RocketVII/Atomian-tensile-strength-tester/README.md

# Atomian-tensile strength tester 
 A project that aimed to recreate a tensile strength tester

Video links:
https://youtu.be/b_F_LkmHzbg
 
https://youtube.com/shorts/Y3lAOohDtaM
 
https://youtube.com/shorts/8C9w-N7GyHU

## Repository Contents:
The Repository contains a the needed documents to recreate the project.
The project focused on achieve great ease of use functionality by creating a User friendly interface and removing the dependency on the laptop
By using a TFT Screen to display the interface in addition to a live plot the project
in addition to an SD card to export the needed data in combination to RTC module recreate some of the Commercial systems functionality
This created the framework for future Tensile Strength testers that utilize the Arduino without the need for the Arduino IDE after the set up

## System Parts:
* [Fishing Reel](https://www.amazon.com/dp/B07HRM2SMN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)
* [20 kg Load cell ](https://www.amazon.com/Bolsen-Tech-Portable-Electronic-Weighing/dp/B07N5KTQ2L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)
* [USB MicroSD Card Reader/Writer](https://www.adafruit.com/product/939)
* [SD module](https://www.amazon.com/dp/B07BJ2P6X6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)
* [TFT LCD display](https://www.adafruit.com/product/1480)
* [Distance Sensor](https://www.adafruit.com/product/3967)
* [C clamps](https://www.amazon.com/dp/B0991XPLGM?ref=ppx_yo2ov_dt_b_product_details&th=1)
* [DS3231 AT24C32 IIC RTC Module Clock](https://www.amazon.com/AT24C32-Replace-Arduino-Batteries-Included/dp/B07Q7NZTQS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)
* [Arduino Mega](https://www.amazon.com/dp/B01H4ZLZLQ?psc=1&ref=ppx_yo2ov_dt_b_product_details)
* [16 Keys Matrix Keypad](https://www.amazon.com/dp/B07B4DR5SH?psc=1&ref=ppx_yo2ov_dt_b_product_details)

## Software Dependencies:
* [Adafruit GFX Library](https://github.com/adafruit/Adafruit-GFX-Library)
* [HX711](https://github.com/bogde/HX711)
* [Adafruit VL53L1X Library](https://github.com/adafruit/Adafruit_VL53L1X)
* [RTClib](https://github.com/adafruit/RTClib)
* [Keypad library for Arduino](https://github.com/Chris--A/Keypad)
* [Adafruit ILI9341 Arduino Library](https://github.com/adafruit/Adafruit_ILI9341)
