RocketVII/Atomian-tensile-strength-tester/Presentation/Team3_Final_presentation.pdf

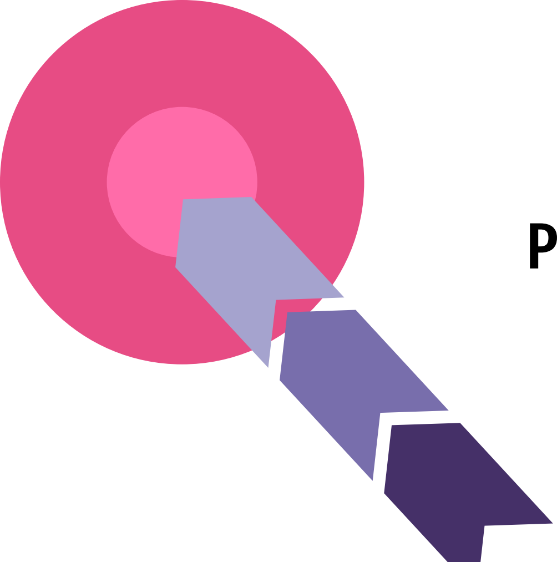
[picture p11: figure]

# Project Goals

### Team 3

# Project Goals

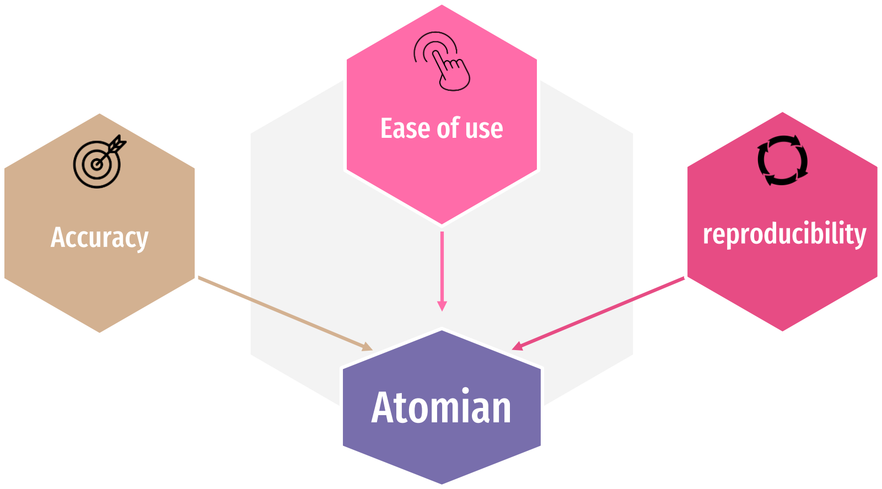
[picture p12: figure]
Atomian; reproducibility; Ease of use; Accuracy

# Identifying The Old System Issues

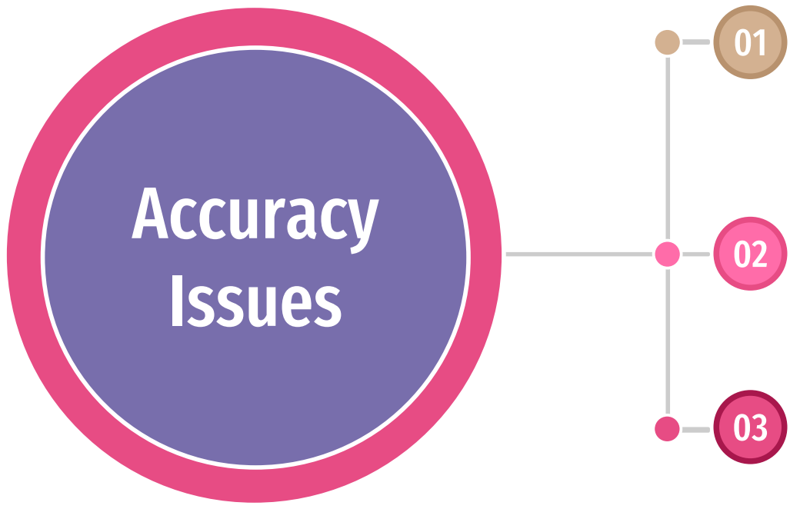
[picture p13: figure]
Accuracy Issues

# Load cell

# Distance Sensor

# Applying force

# Old system Data collection proccess

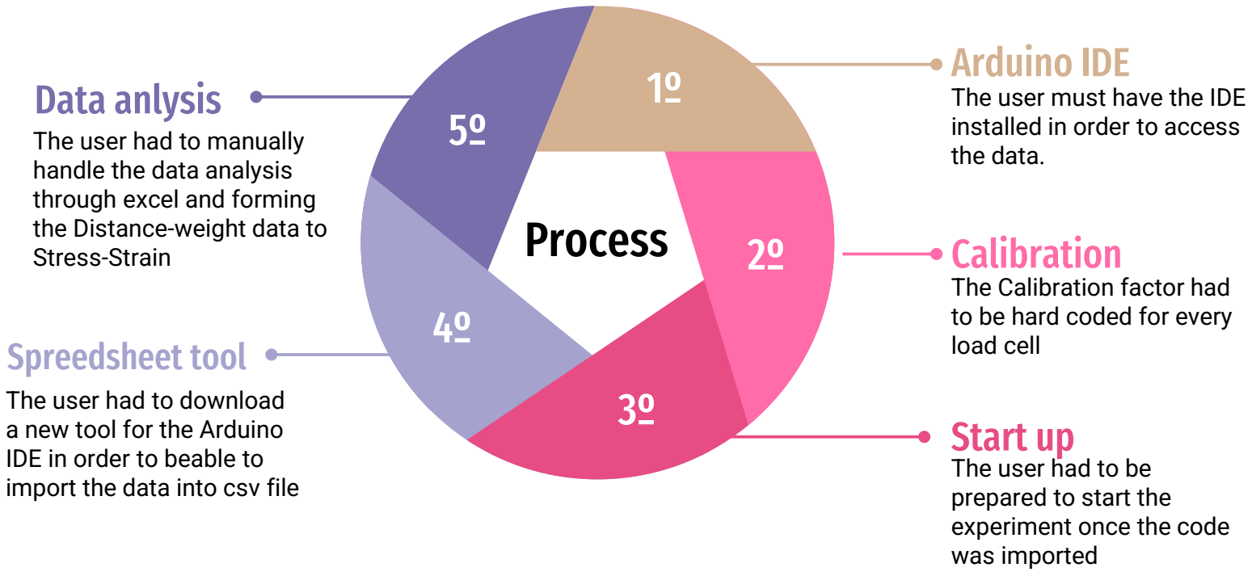
[picture p14: figure]
Data anlysis; The user had to manually handle the data analysis through excel and forming the Distance-weight data to Stress-Strain; Spreedsheet tool; The user had to download a new tool for the Arduino IDE in order to beable to import the data into csv file; Start up; The user had to be prepared to start the experiment once the code was imported; Calibration; The Calibration factor had to be hard coded for every load cell; The user must have the IDE installed in order to access the data.; Arduino IDE 1º; Process

# Proposed Solution

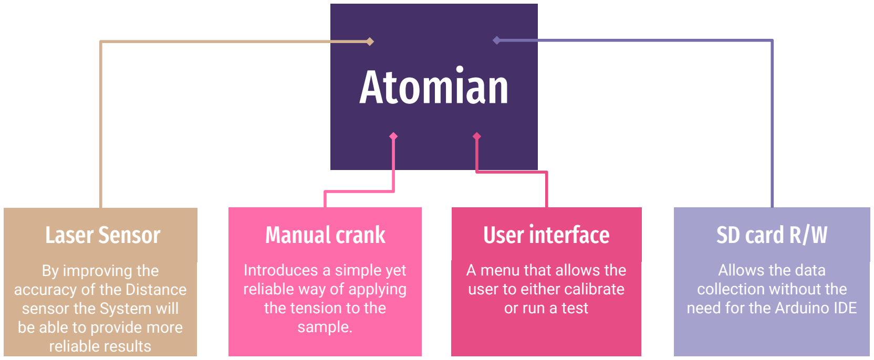
[picture p15: figure]
Atomian; By improving the accuracy of the Distance sensor the System will be able to provide more reliable results; Laser Sensor; Allows the data collection without the need for the Arduino IDE; SD card R/W; A menu that allows the user to either calibrate or run a test; User interface; Introduces a simple yet reliable way of applying the tension to the sample.; Manual crank

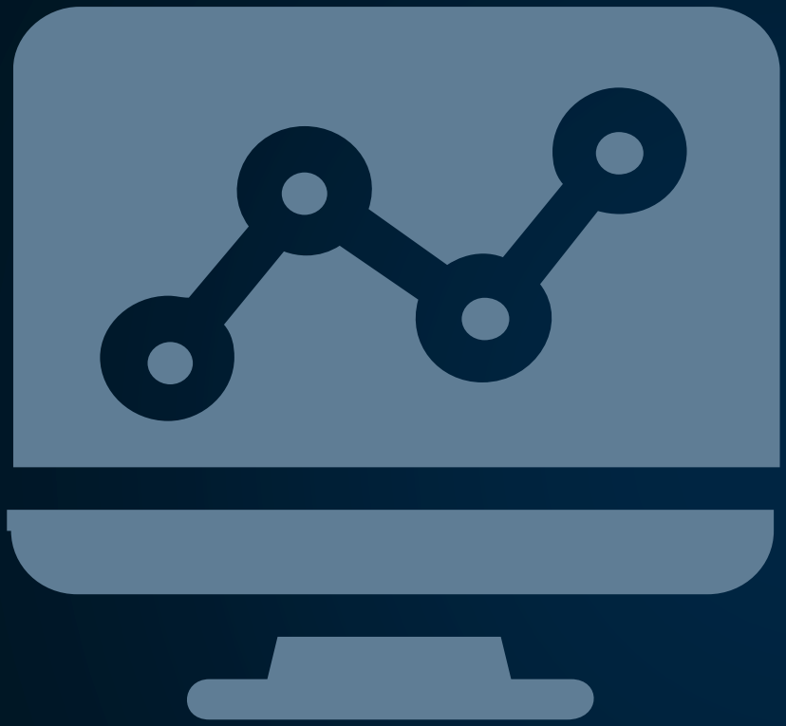
[picture p16: figure]

# Project Software

# Software Features

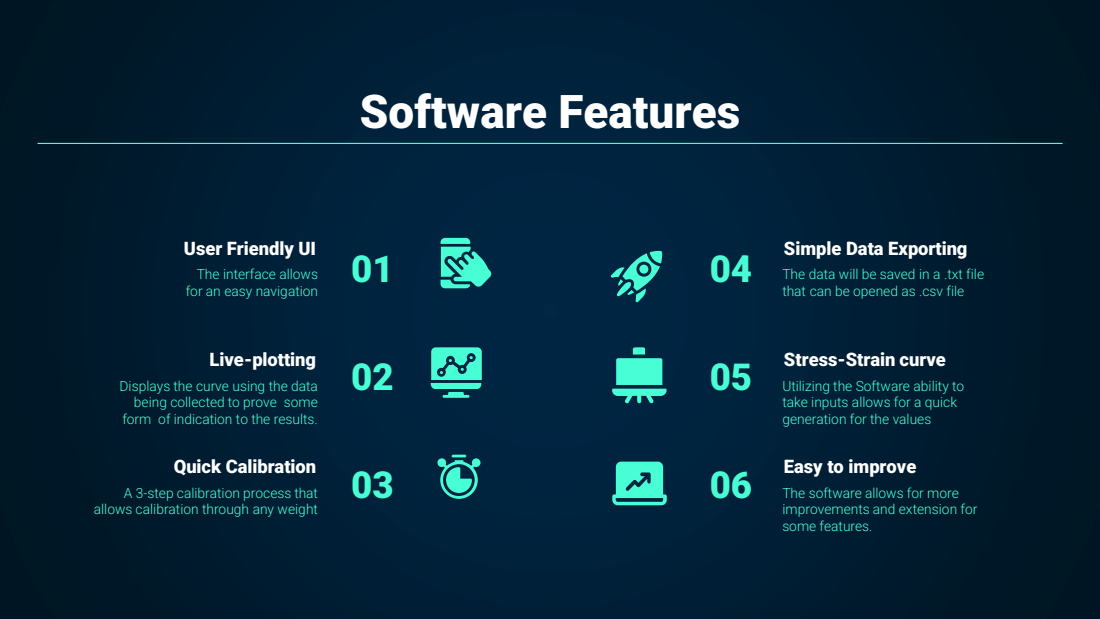
[picture p17: page 7]
Live-plotting; Quick Calibration

User Friendly UI

Simple Data Exporting

The interface allows
for an easy navigation

The data will be saved in a .txt file
that can be opened as .csv file

Stress-Strain curve

Displays the curve using the data
being collected to prove some
form of indication to the results.

Utilizing the Software ability to
take inputs allows for a quick
generation for the values

Easy to improve

A 3-step calibration process that
allows calibration through any weight

The software allows for more
improvements and extension for
some features.

# State machine

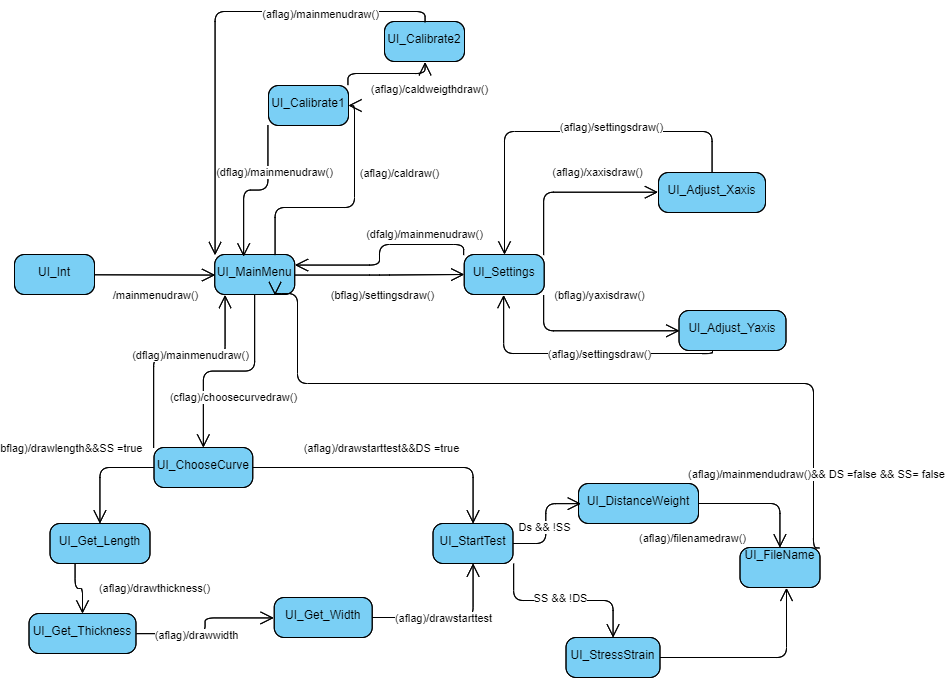
[picture p18: figure]

# Calibration process

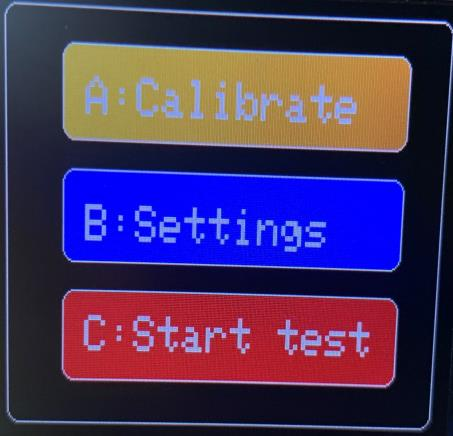
[picture p19: figure]

Select the calibration option by pressing A

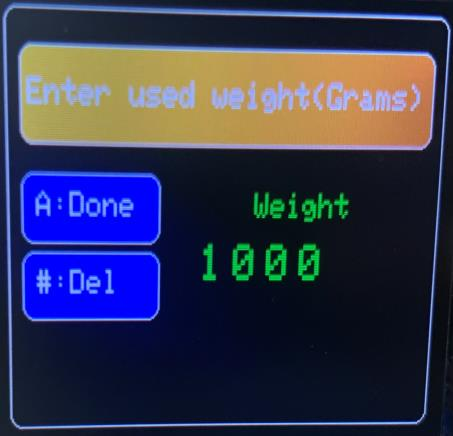
[picture p20: figure]

Put the weight and then
enter the value in grams
then press A

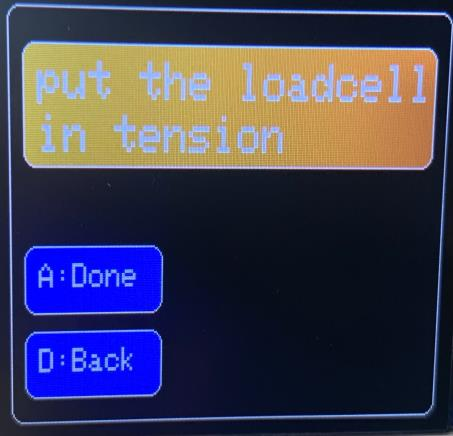
[picture p21: figure]

Following the instruction
simply pull the Reel
And then press A
Main menu | Tare menu | Calibrate
The value is now saved

Done!

# Live plot

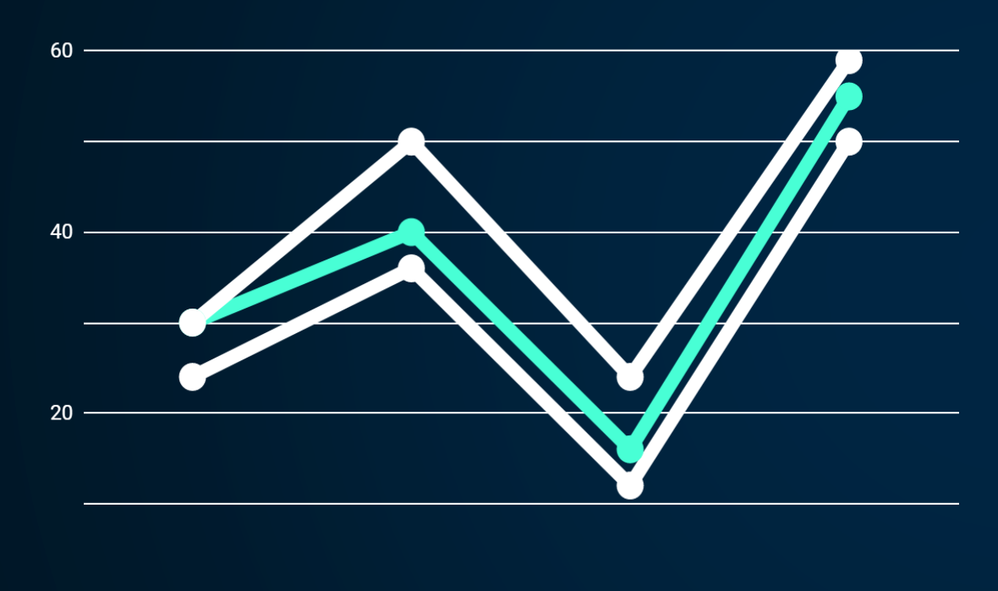
[picture p22: figure]

The plot function start by drawing the background using pre-set Axis values.

Drawing The background

The function can be used on any screen if it uses the Adafruit graphics library

Usable on any TFT screen

- The function utilizes transformations to compare the input value to reference axis value.
- Then it compare it to the previous value in order to figure out the position of the dot
- The final step is drawing the line between this point and the previous one.

Drawing The points

# Settings menu

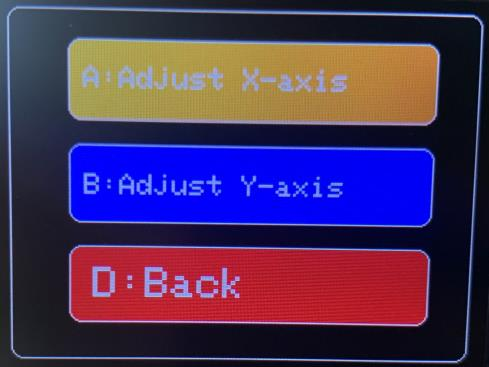
[picture p23: figure]

Select which Axis you
would like to change

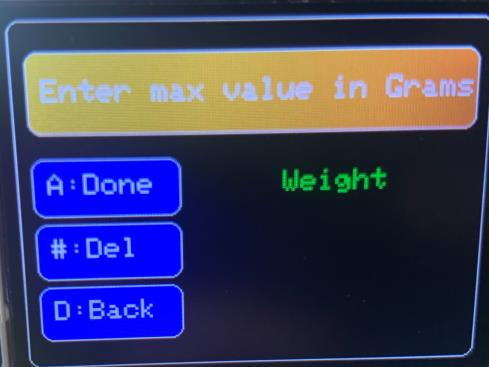
[picture p24: figure]

Enter the expected max
value for the weight

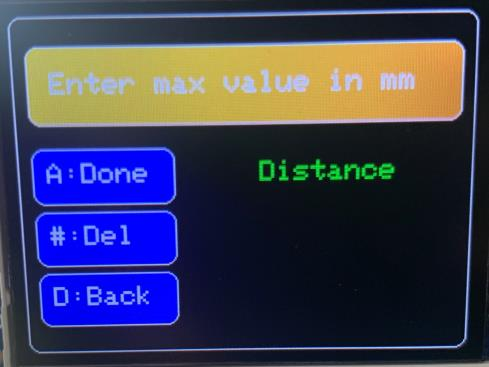
[picture p25: figure]

Enter the expected max
value for the Distance
Settings menu | X-axis | Y-axis

# Live plot example

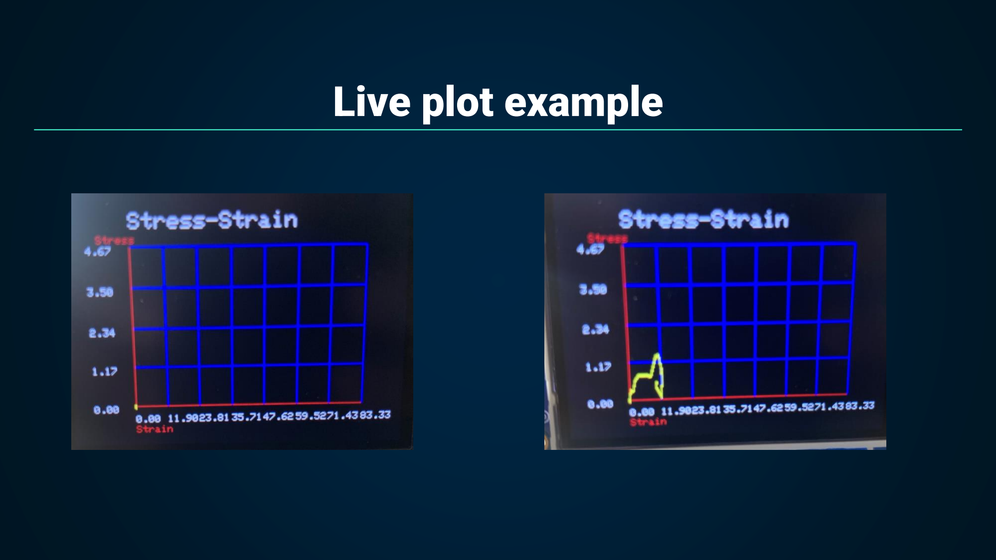
[picture p26: page 12]

# Stress-Strain menus

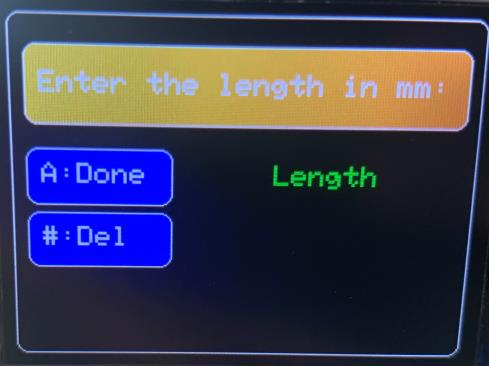
[picture p27: figure]

Enter the length of the
sample in mm

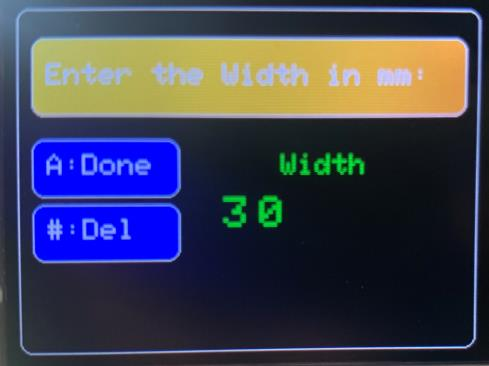
[picture p28: figure]

Enter the width of the
sample in mm

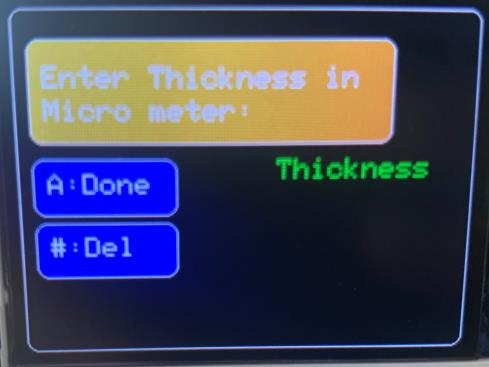
[picture p29: figure]

Enter the Thickness of the sample in micrometer

Length menu | Thickness menu | Width menu

# Saving Data with SD card

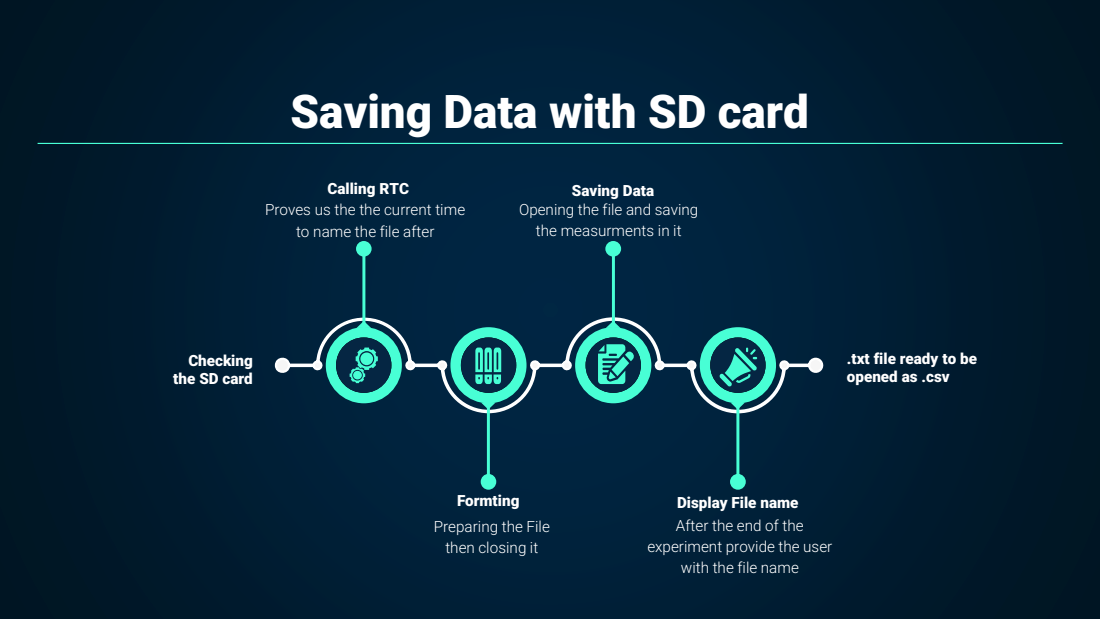
[picture p30: page 14]
Calling RTC; Saving Data

Proves us the the current time
to name the file after

Opening the file and saving
the measurments in it

Checking
the SD card

.txt file ready to be
opened as .csv

Formting
Preparing the File
then closing it

Display File name
After the end of the
experiment provide the user
with the file name

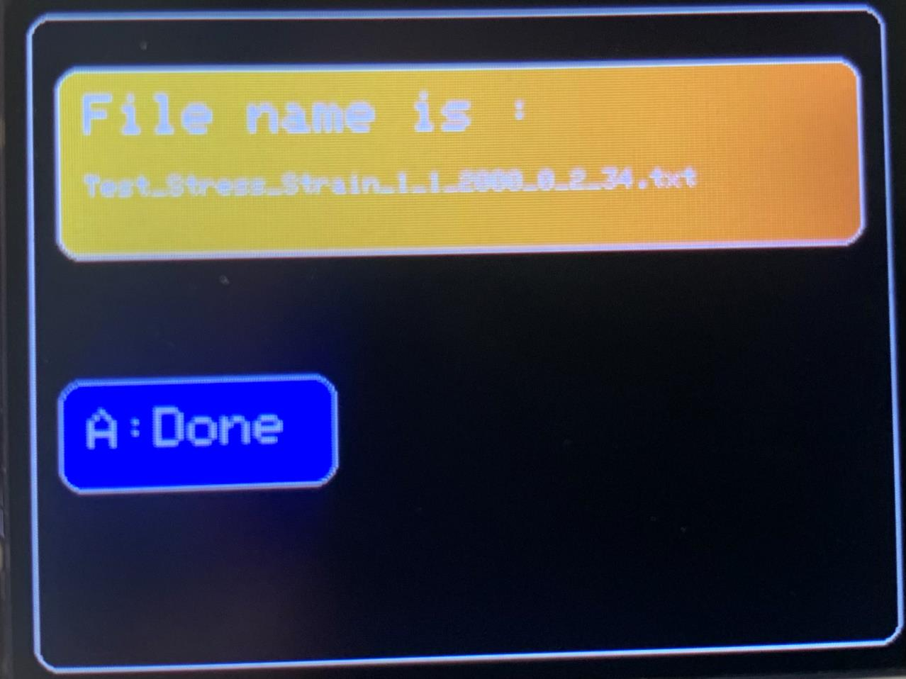
[picture p31: figure]

# Manual

01 The range sensor has less of a

chance to have a
technological error

# Accuracy

02 The range sensor has a

smaller deviation from the actual measured distance

# Instilation

03
Less coding required
compared to other options

04

# Why A Lazer Range Sensor instead of other possiblitys?

# Why Not A Motor

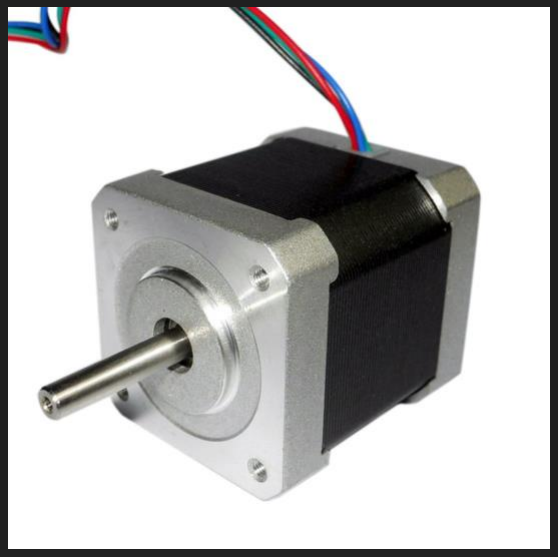
[picture p32: figure]
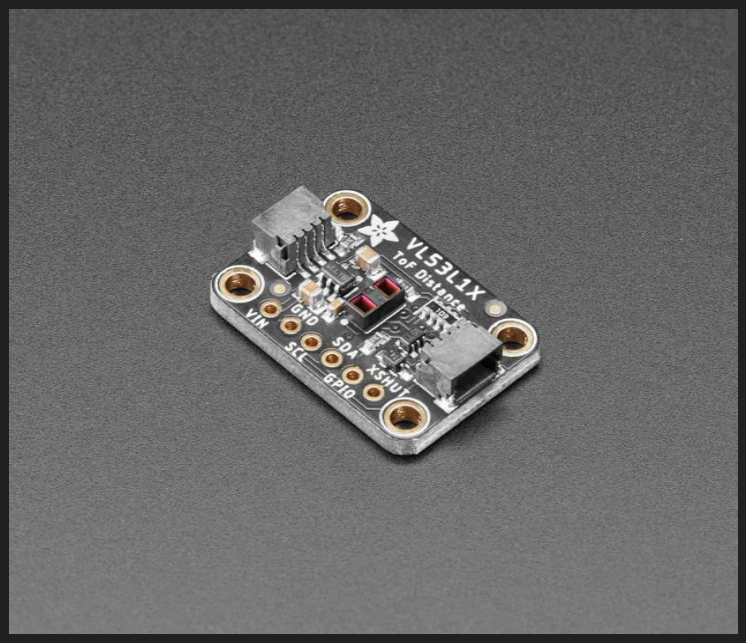
[picture p33: figure]

VS

# Stepper Motor vs Lazer Sensor

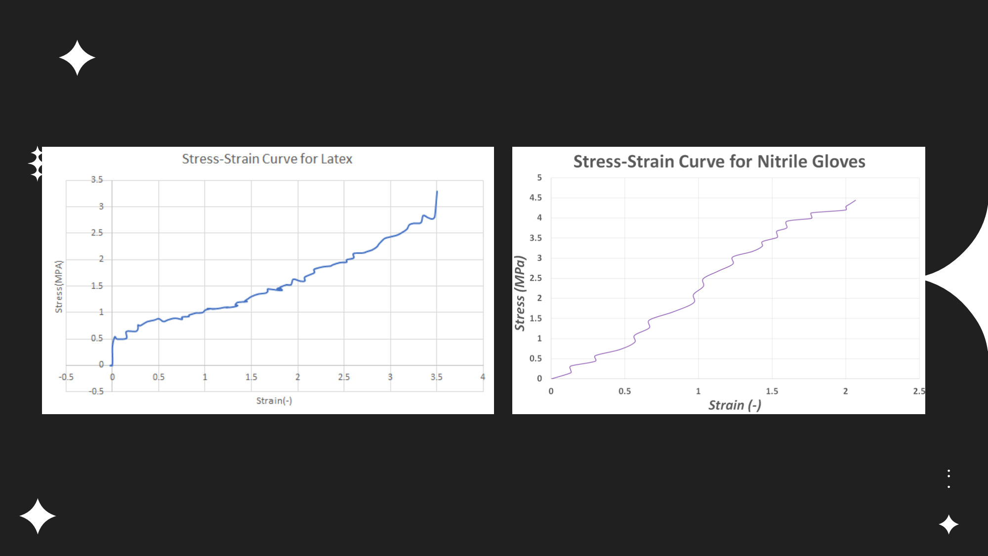
[picture p34: page 19]

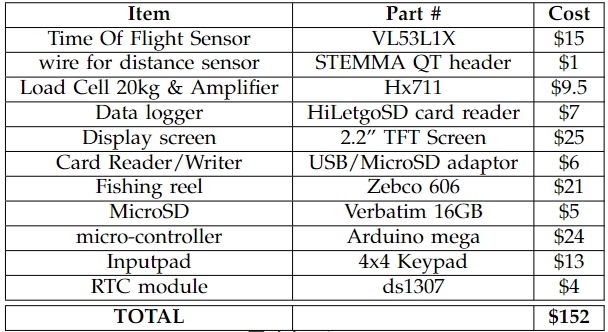
[picture p35: figure]

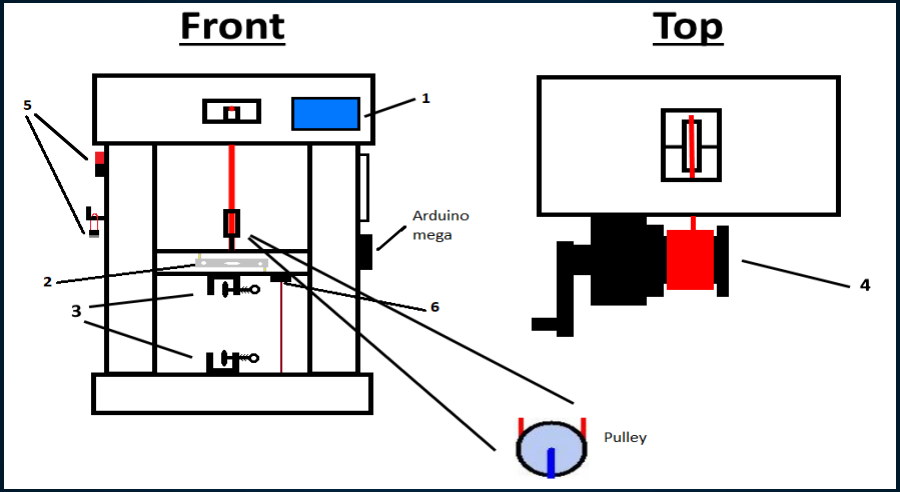
[picture p36: figure]

- 3 pulley mechanical advantage
- Supports 3x the applied load
- Allows for loads greater than 4kg to be applied (up to 6kg)
- Failsafe to prevent damaging load cell
- Crank provides greater control and consistency when taking measurements
- Entire system costs less than $30

# Crank and Pulley System

# Upgraded Clamps

- Much greater clamping strength than original design
- Prevents slipping when using thin samples
- Heavy duty to grip and hold larger samples
- Much quicker and easier to secure samples than original design

# Contribution

Q&A
